Exocet-Polytechnique/ExospineV2/ExoSpineV2/ExoSpineV2_schematic.pdf

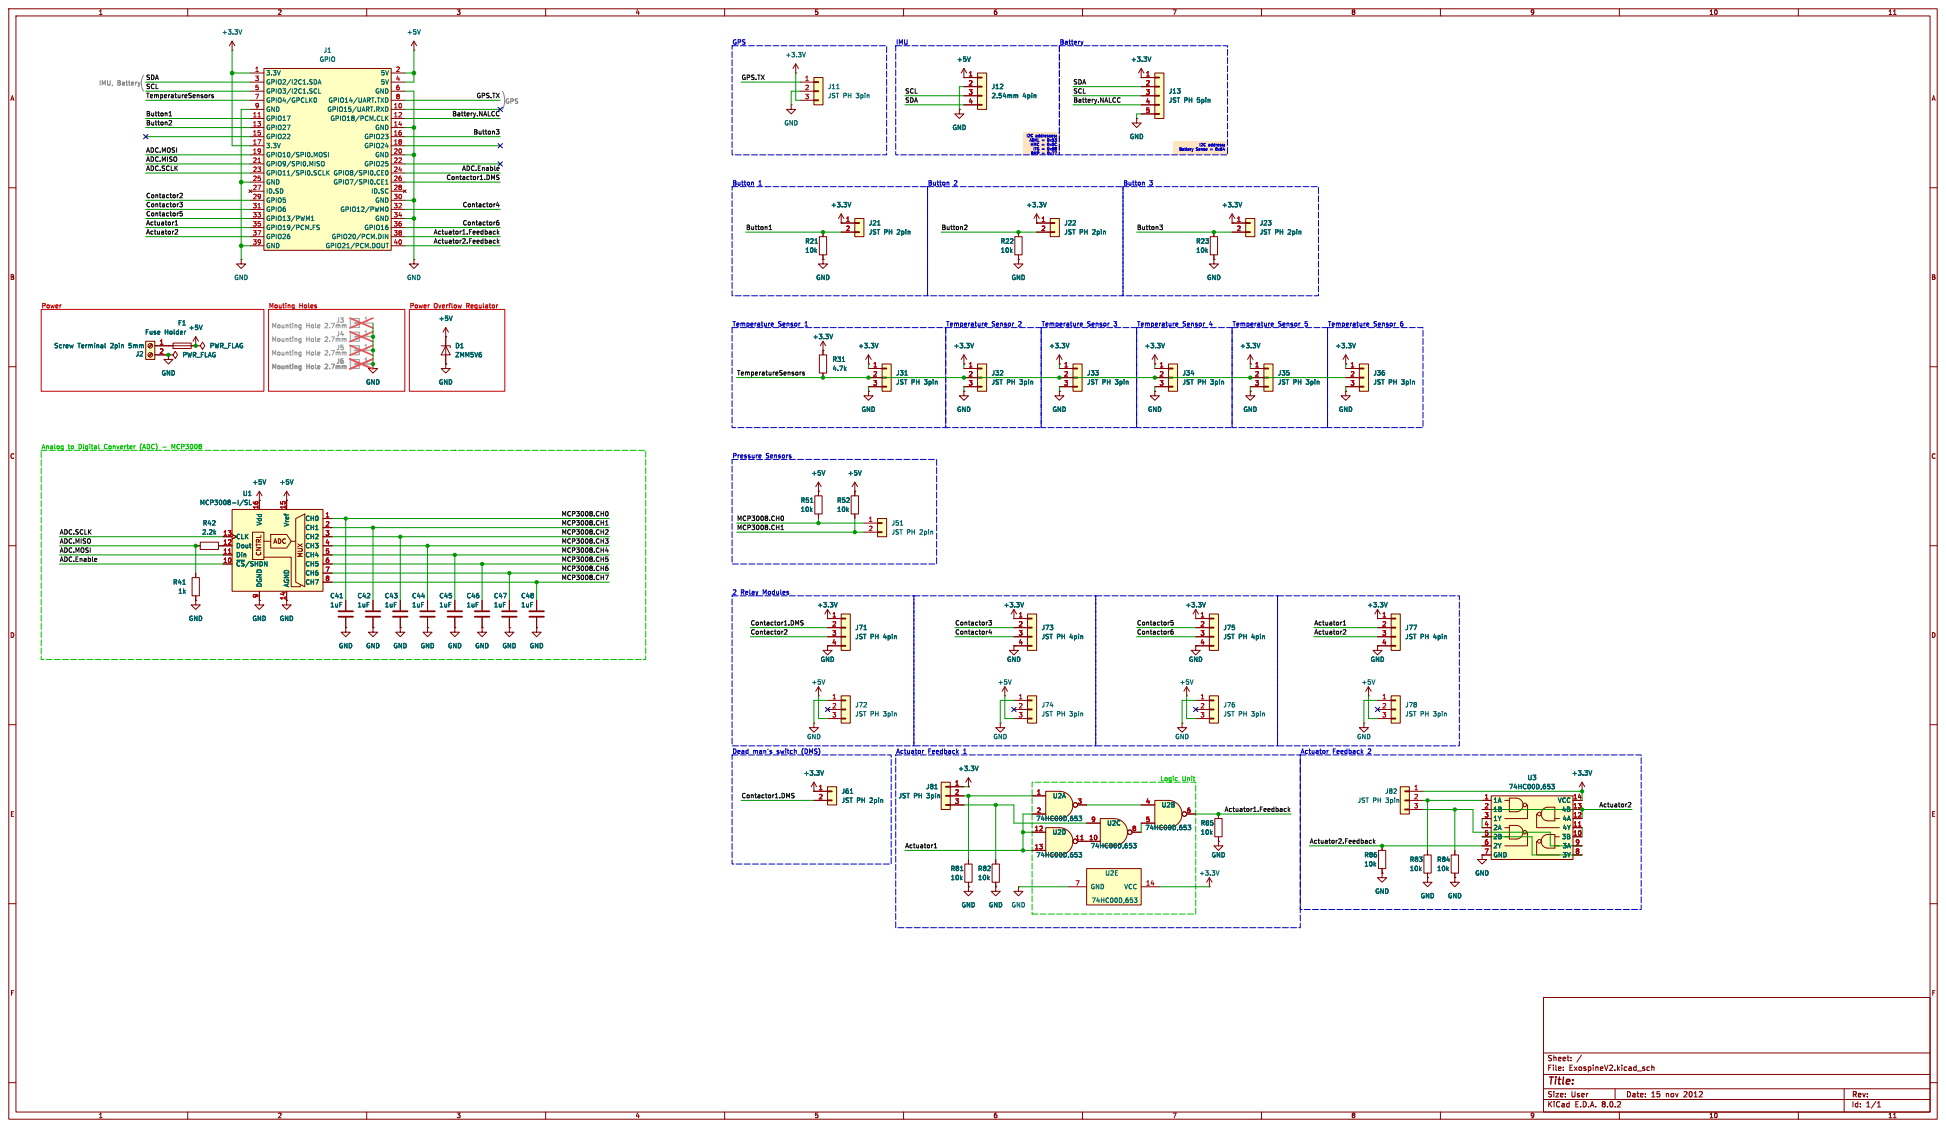
[picture p1: page 1]

Contactor2 Actuator1 Actuator2 Contactor5 ADC.MOSI Button2 Button1 SCL SDA

Id: 1/1 Title: File: ExospineV2.kicad_sch Sheet: /
