Exocet-Polytechnique/ExospineV2/ExoSpineV2/ExospineV2_PCB_back_layer.pdf

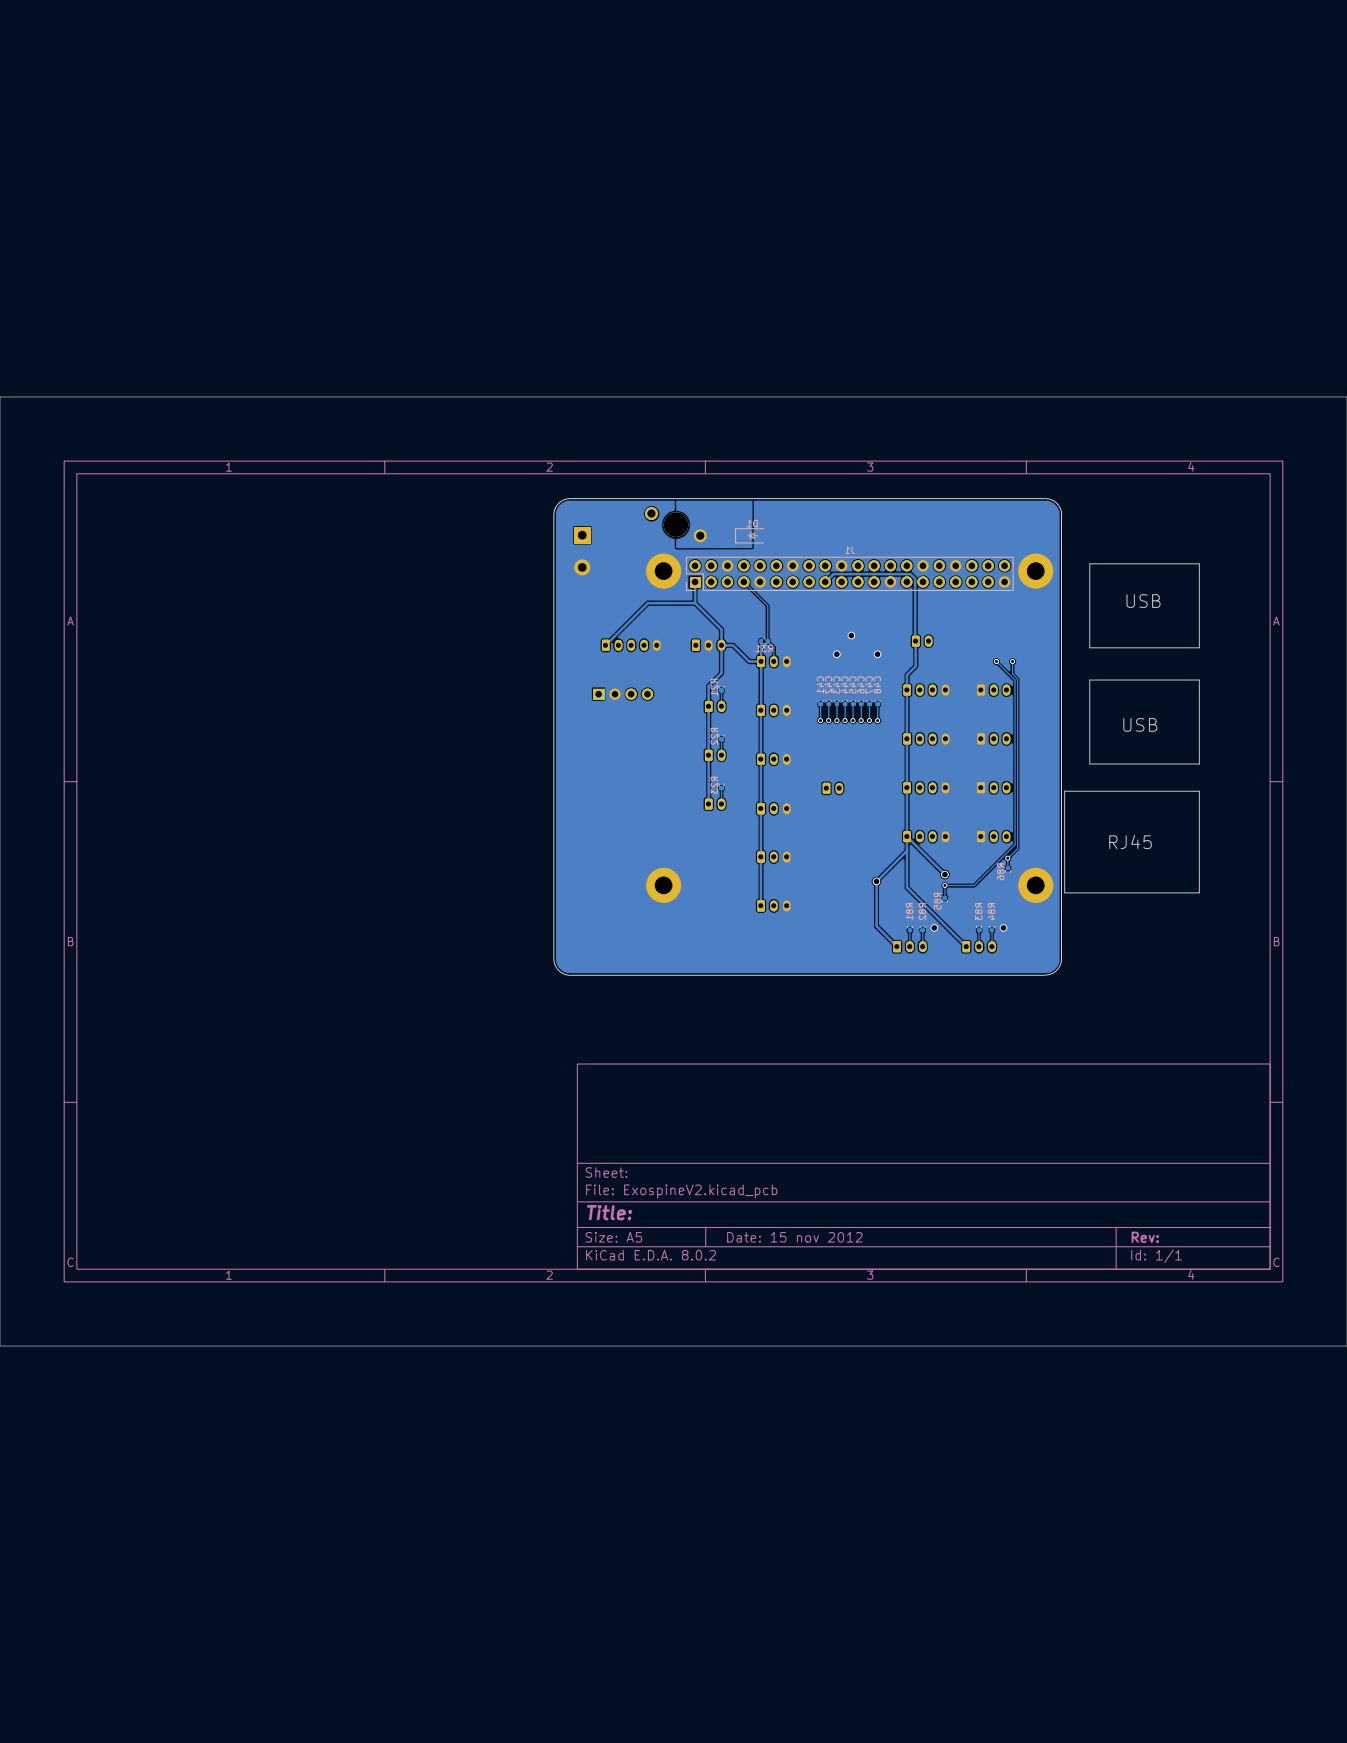
[picture p2: page 1]
