Exocet-Polytechnique/ExospineV2/ExoSpineV2/ExospineV2_PCB_front_layer.pdf

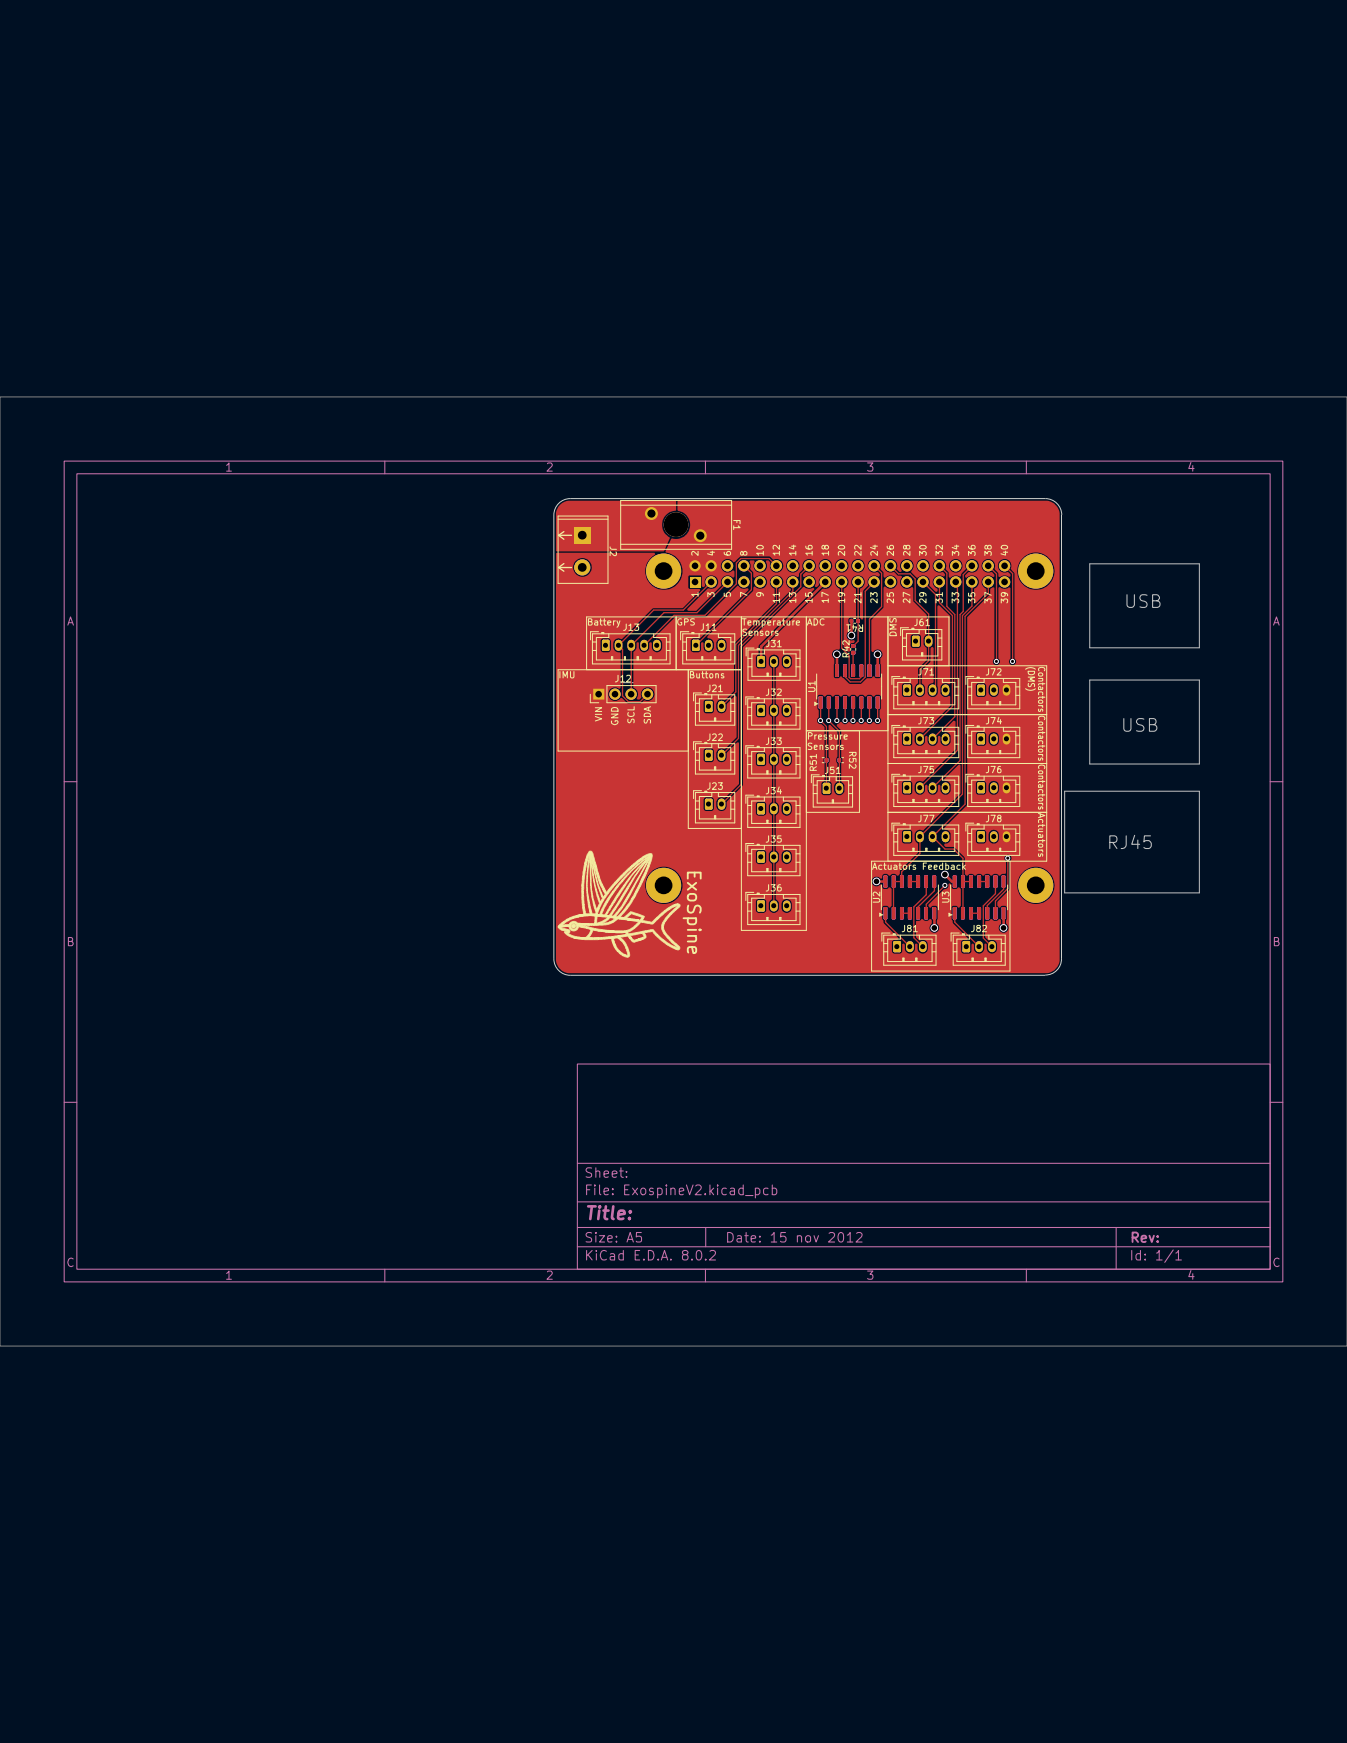
[picture p3: page 1]
