Exocet-Polytechnique/ExospineV2/ExoSpineV2/ExospineV2.kicad_pcb

## KiCad design ExoSpineV2/ExospineV2.kicad_pcb (2024-05-23)

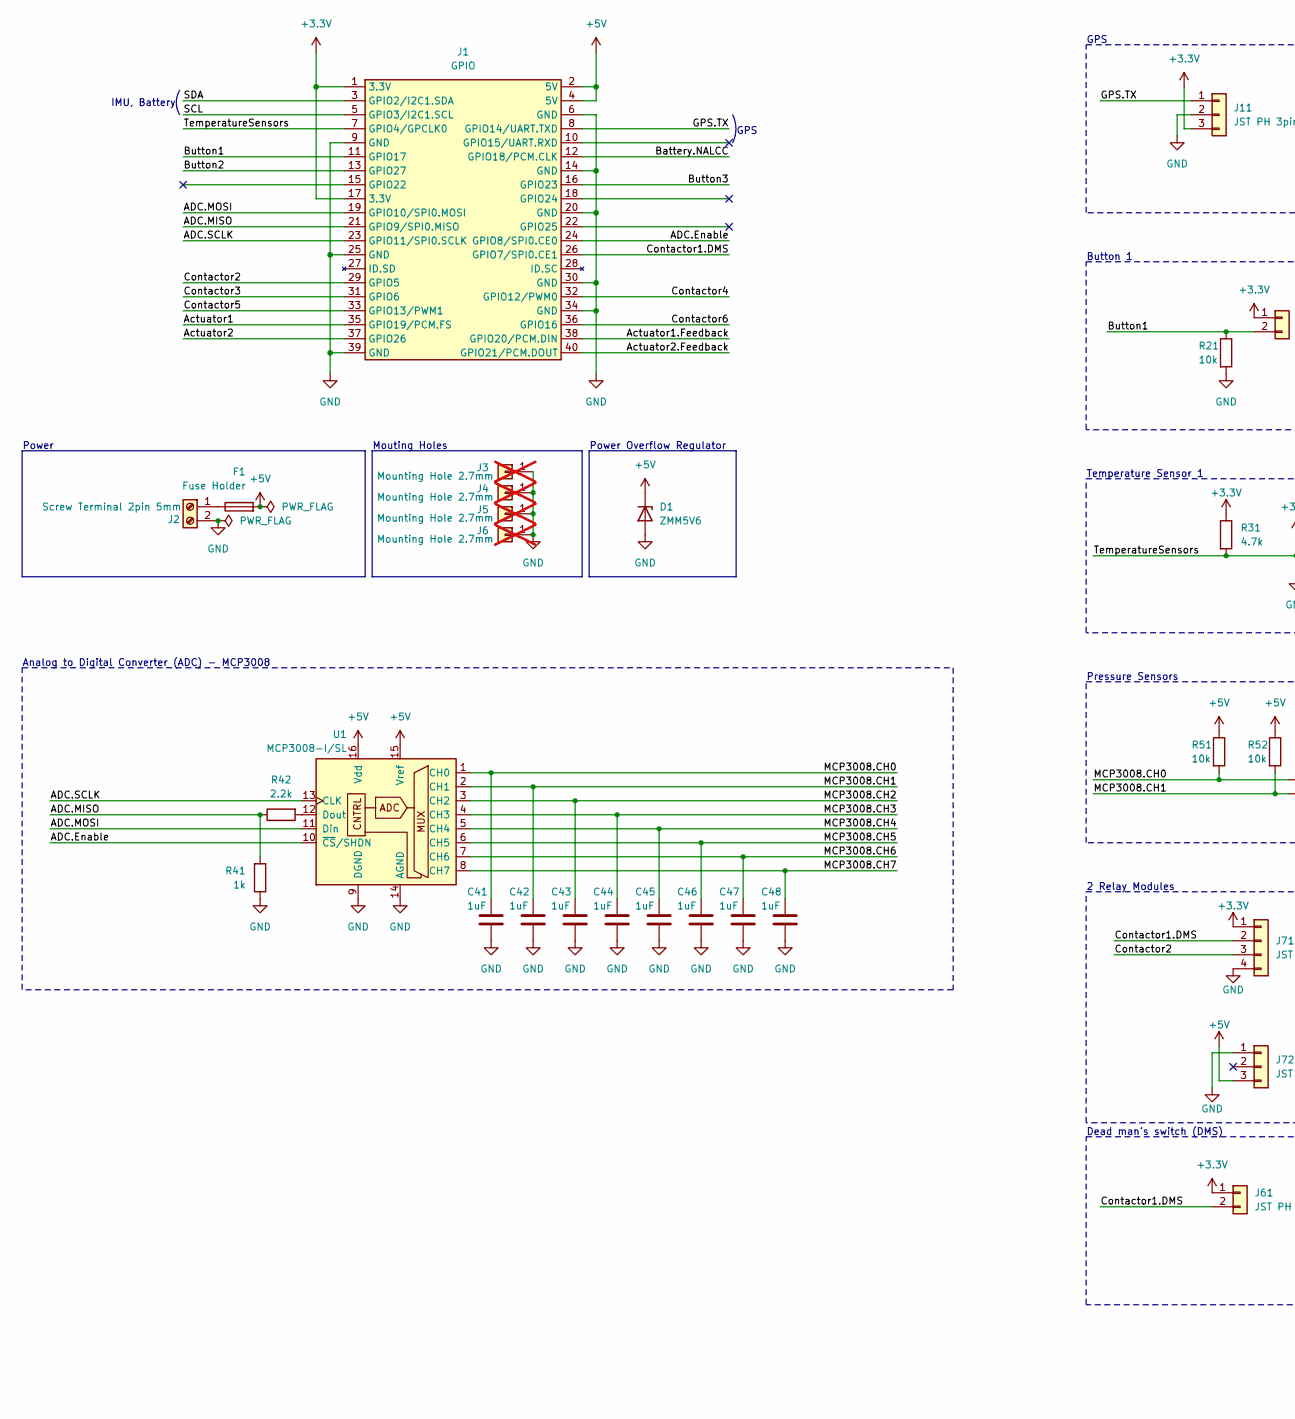
[picture p4: schematic ExospineV2.kicad_sch, part in row 1, column 1]

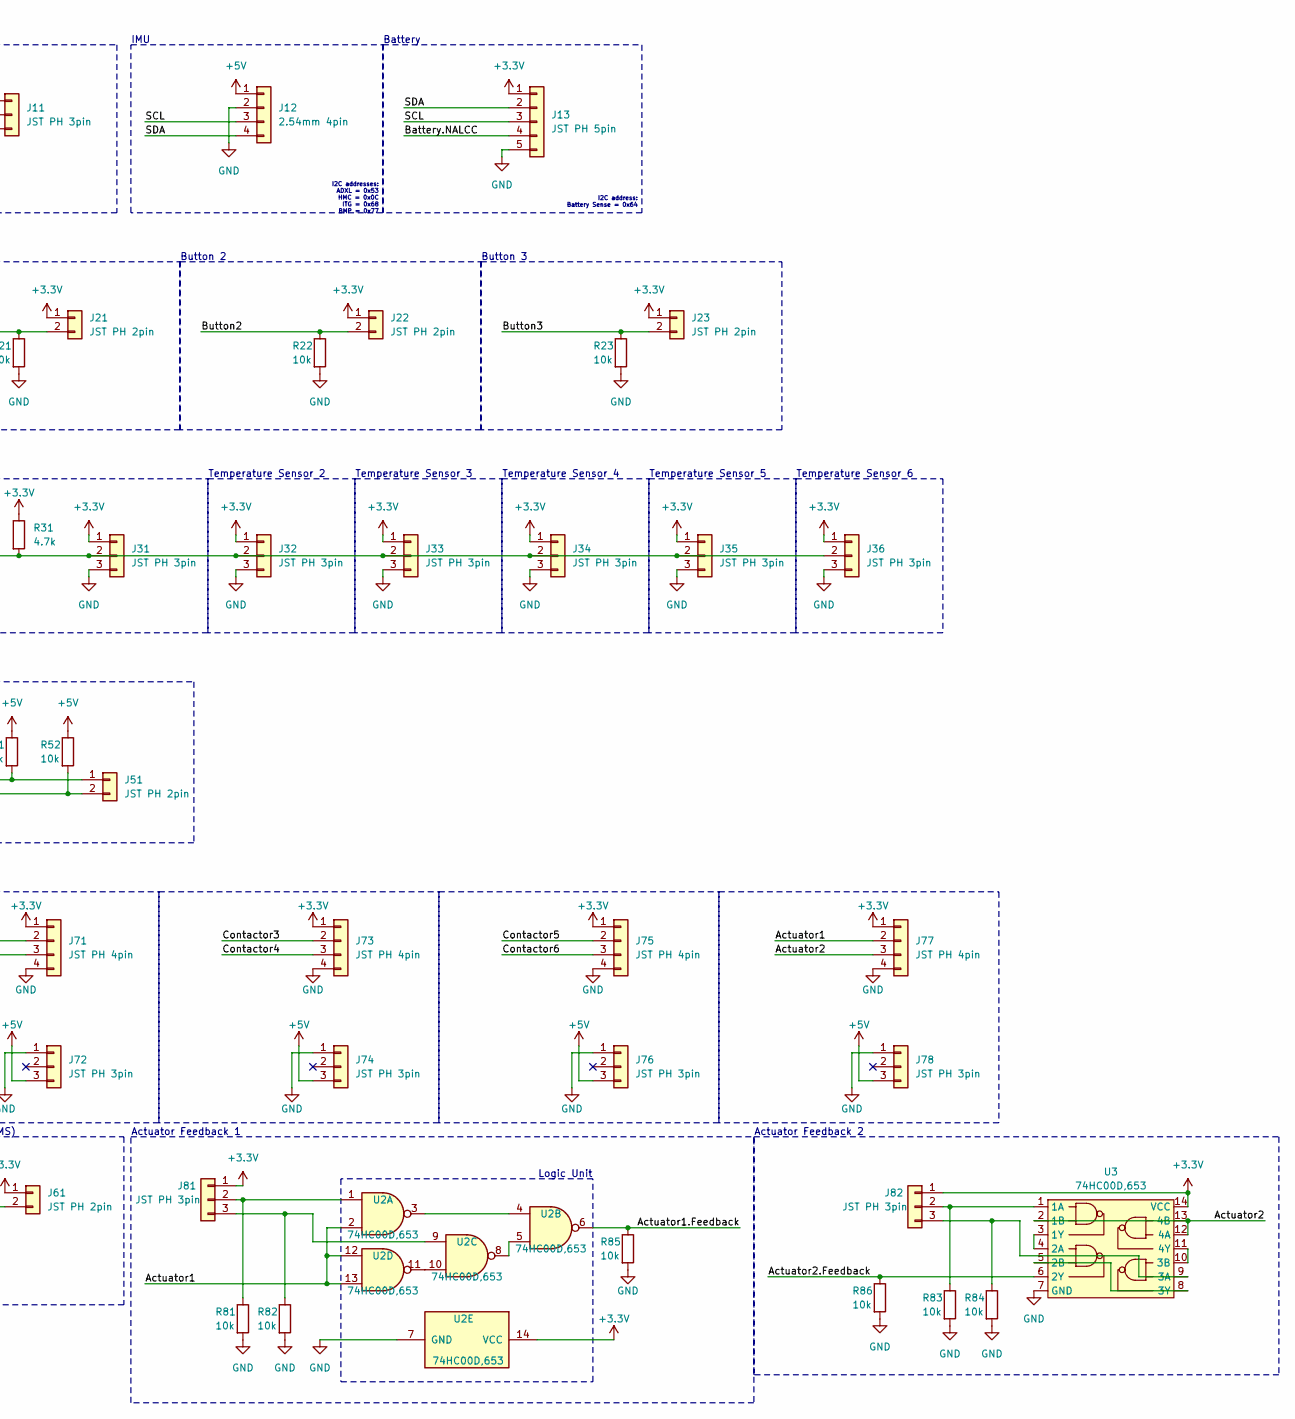
[picture p5: schematic ExospineV2.kicad_sch, part in row 1, column 2]

Parts:
C41, C42, C43, C44, C45, C46, C47, C48: 1uF; C_0402_1005Metric; JLCPCB Part Number C52923
D1: ZMM5V6; D_MiniMELF; JLCPCB Part Number C5345993
F1: Fuse Holder; [Mouser~]01530008(Littelfuse); JLCPCB Part Number C206907
J1: GPIO; PinSocket_2x20_P2.54mm_Vertical; JLCPCB Part Number C2977589
J2: Screw Terminal 2pin 5mm; [Exocet]MX126-5.0-02P-GN01-Cu-S-A; JLCPCB Part Number C5188434
J3, J4, J5, J6: Mounting Hole 2.7mm; MountingHole_2.7mm_Pad; not fitted
J11, J31, J32, J33, J34, J35, J36, J72, J74, J76, J78, J81, J82: JST PH 3pin; JST_PH_B3B-PH-K_1x03_P2.00mm_Vertical; JLCPCB Part Number C131339
J12: 2.54mm 4pin; PinHeader_1x04_P2.54mm_Vertical; JLCPCB Part Number C5116483
J13: JST PH 5pin; JST_PH_B5B-PH-K_1x05_P2.00mm_Vertical; JLCPCB Part Number C157993
J21, J22, J23, J51, J61: JST PH 2pin; JST_PH_B2B-PH-K_1x02_P2.00mm_Vertical; JLCPCB Part Number C131337
J71, J73, J75, J77: JST PH 4pin; JST_PH_B4B-PH-K_1x04_P2.00mm_Vertical; JLCPCB Part Number C131334
R21, R22, R23, R51, R52, R81, R82, R83, R84, R85, R86: 10k; R_0402_1005Metric; JLCPCB Part Number C25744
R31: 4.7k; R_0402_1005Metric; JLCPCB Part Number C25900
R41: 1k; R_0402_1005Metric; JLCPCB Part Number C11702
R42: 2.2k; R_0402_1005Metric; JLCPCB Part Number C25879
U1: MCP3008-I/SL; SOIC-16_3.9x9.9mm_P1.27mm; JLCPCB Part Number C1520159
U2, U3: 74HC00D,653; SOIC-14_3.9x8.7mm_P1.27mm; JLCPCB Part Number C5586

Connections:
+3.3V: J1.1 (3.3V), J1.17 (3.3V), J11.3, J13.1, J21.1, J22.1, J23.1, J31.1, J32.1, J33.1, J34.1, J35.1, J36.1, J61.1, J71.1, J73.1, J75.1, J77.1, J81.1, J82.1, R31.1, U2.14 (VCC), U3.14 (VCC)
+5V: D1.1 (K), F1.2, J1.2 (5V), J1.4 (5V), J12.1, J72.3, J74.3, J76.3, J78.3, R51.1, R52.1, U1.15 (Vref), U1.16 (Vdd)
/ADC.Enable: J1.24 (GPIO8/SPI0.CE0), U1.10 (~CS/SHDN)
/ADC.MISO: J1.21 (GPIO9/SPI0.MISO), R41.2, R42.1
/ADC.MOSI: J1.19 (GPIO10/SPI0.MOSI), U1.11 (Din)
/ADC.SCLK: J1.23 (GPIO11/SPI0.SCLK), U1.13 (CLK)
/Actuator1: J1.35 (GPIO19/PCM.FS), J77.2, U2.2, U2.12, U2.13
/Actuator1.Feedback: J1.38 (GPIO20/PCM.DIN), R85.1, U2.6
/Actuator2: J1.37 (GPIO26), J77.3, U3.2 (1B), U3.12 (4A), U3.13 (4B)
/Actuator2.Feedback: J1.40 (GPIO21/PCM.DOUT), R86.1, U3.6 (2Y)
/Battery.NALCC: J1.12 (GPIO18/PCM.CLK), J13.4
/Button1: J1.11 (GPIO17), J21.2, R21.1
/Button2: J1.13 (GPIO27), J22.2, R22.1
/Button3: J1.16 (GPIO23), J23.2, R23.1
/Contactor1.DMS: J1.26 (GPIO7/SPI0.CE1), J61.2, J71.2
/Contactor2: J1.29 (GPIO5), J71.3
/Contactor3: J1.31 (GPIO6), J73.2
/Contactor4: J1.32 (GPIO12/PWM0), J73.3
/Contactor5: J1.33 (GPIO13/PWM1), J75.2
/Contactor6: J1.36 (GPIO16), J75.3
/GPS.TX: J1.8 (GPIO14/UART.TXD), J11.1
/MCP3008.CH0: C41.1, J51.1, R51.2, U1.1 (CH0)
/MCP3008.CH1: C42.1, J51.2, R52.2, U1.2 (CH1)
/MCP3008.CH2: C43.1, U1.3 (CH2)
/MCP3008.CH3: C44.1, U1.4 (CH3)
/MCP3008.CH4: C45.1, U1.5 (CH4)
/MCP3008.CH5: C46.1, U1.6 (CH5)
/MCP3008.CH6: C47.1, U1.7 (CH6)
/MCP3008.CH7: C48.1, U1.8 (CH7)
/SCL: J1.5 (GPIO3/I2C1.SCL), J12.3, J13.3
/SDA: J1.3 (GPIO2/I2C1.SDA), J12.4, J13.2
/TemperatureSensors: J1.7 (GPIO4/GPCLK0), J31.2, J32.2, J33.2, J34.2, J35.2, J36.2, R31.2
GND: C41.2, C42.2, C43.2, C44.2, C45.2, C46.2, C47.2, C48.2, D1.2 (A), J1.6 (GND), J1.9 (GND), J1.14 (GND), J1.20 (GND), J1.25 (GND), J1.30 (GND), J1.34 (GND), J1.39 (GND), J2.2, J3.1, J4.1, J5.1, J6.1, J11.2, J12.2, J13.5, J31.3, J32.3, J33.3, J34.3, J35.3, J36.3, J71.4, J72.1, J73.4, J74.1, J75.4, J76.1, J77.4, J78.1, R21.2, R22.2, R23.2, R41.1, R81.2, R82.2, R83.2, R84.2, R85.2, R86.2, U1.9 (DGND), U1.14 (AGND), U2.7 (GND), U3.7 (GND)
unnamed: F1.1, J2.1
unnamed: J81.2, R81.1, U2.1
unnamed: J81.3, R82.1, U2.9
unnamed: J82.2, R83.1, U3.1 (1A)
unnamed: J82.3, R84.1, U3.9 (3A)
unnamed: R42.2, U1.12 (Dout)
unnamed: U2.3, U2.4
unnamed: U2.5, U2.8
unnamed: U2.10, U2.11
unnamed: U3.3 (1Y), U3.4 (2A)
unnamed: U3.5 (2B), U3.8 (3Y)
unnamed: U3.10 (3B), U3.11 (4Y)

Notes on the sheet:
I2C address: Battery Sense = 0x64
I2C addresses: ADXL = 0x53 HMC = 0x0C ITG = 0x68 BMP = 0x77
Actuator Feedback 1
IMU, Battery
Button 3
Mouting Holes
Power Overflow Regulator
Temperature Sensor 6
2 Relay Modules
Battery
Temperature Sensor 1
IMU
Power
Button 2
GPS
Temperature Sensor 3
Pressure Sensors
Actuator Feedback 2
Button 1
Logic Unit
Analog to Digital Converter (ADC) - MCP3008
Temperature Sensor 5
Temperature Sensor 2
Temperature Sensor 4
Dead man's switch (DMS)

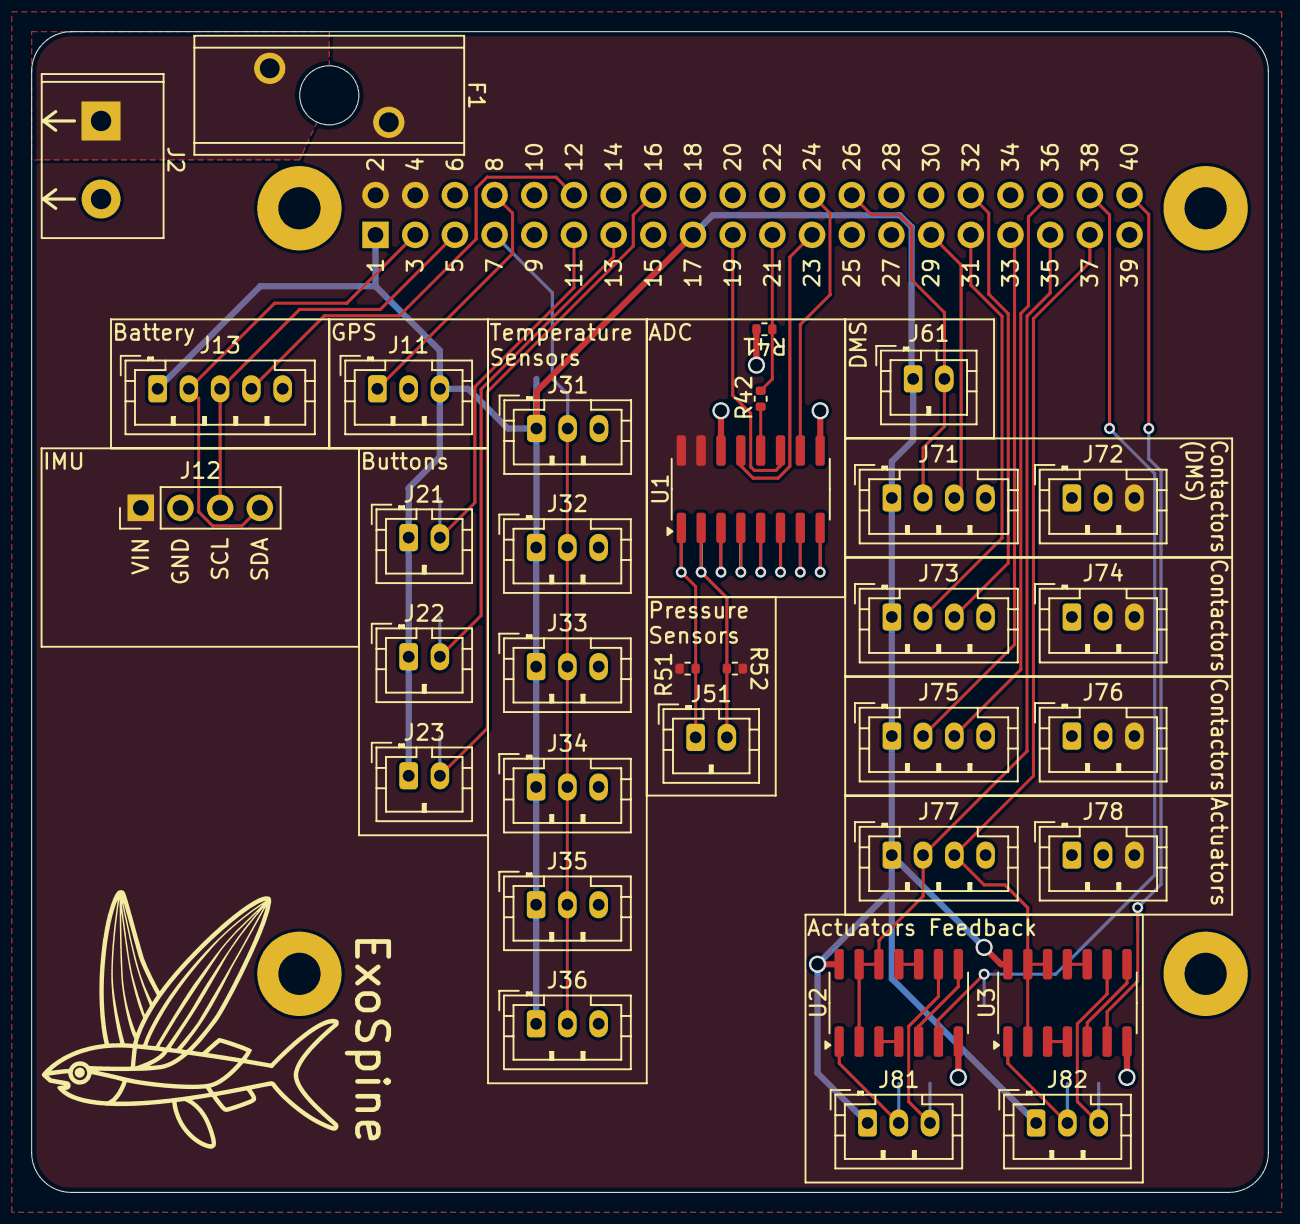
[picture p6: board ExospineV2.kicad_pcb from above]

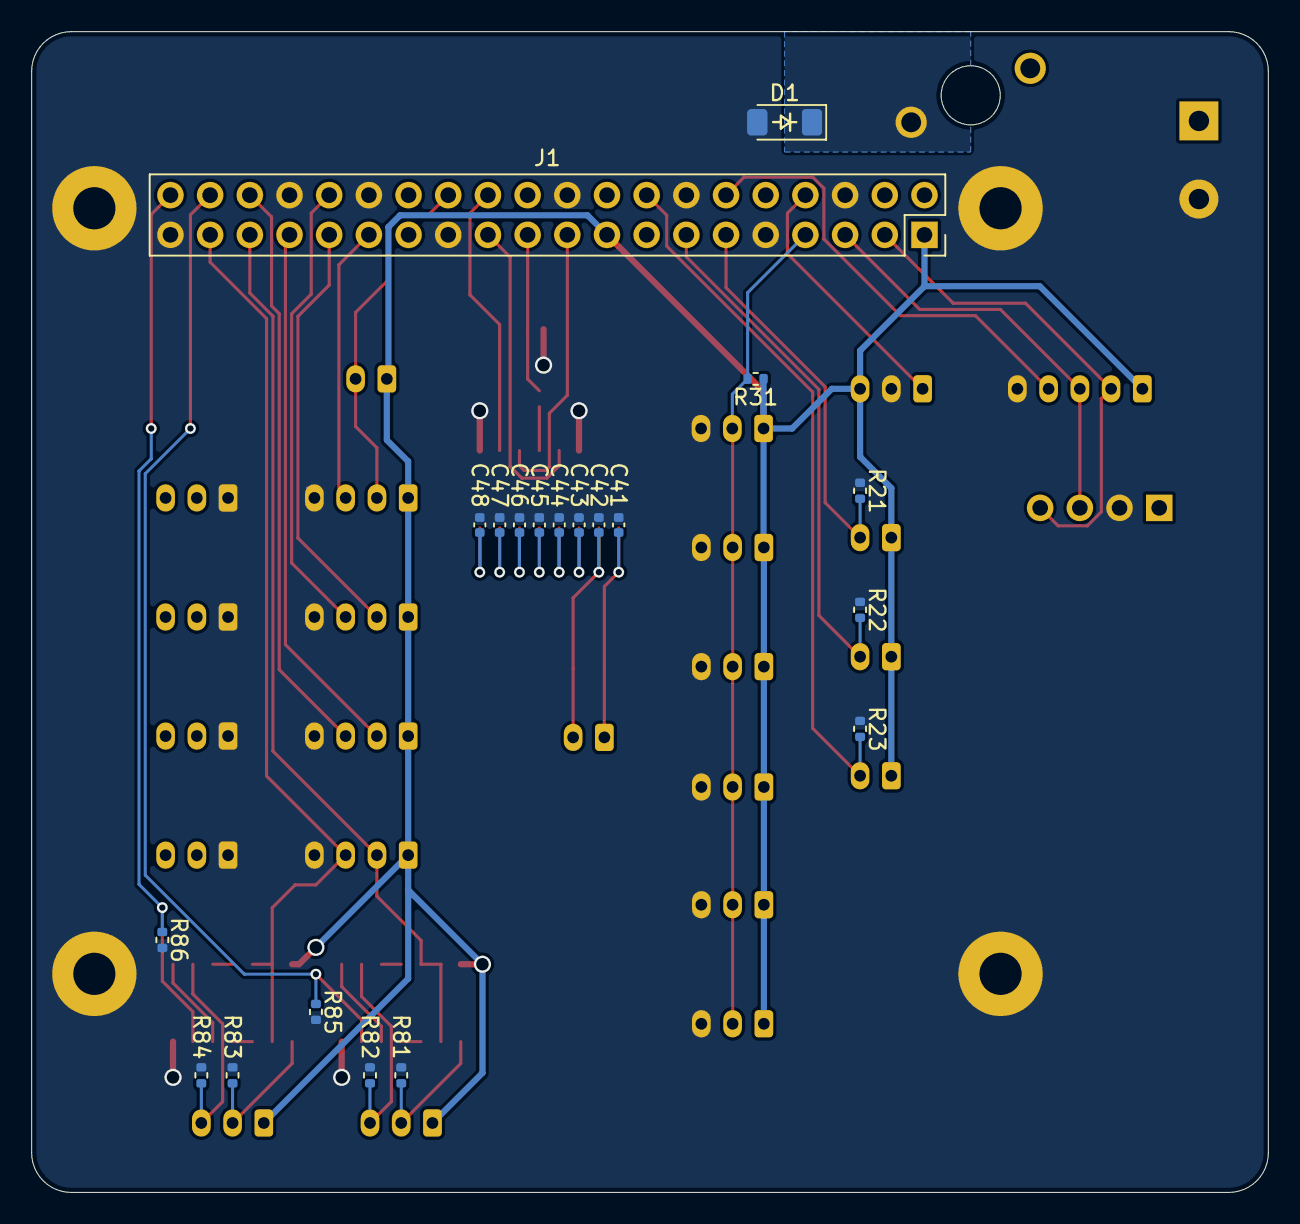
[picture p7: board ExospineV2.kicad_pcb from below]

Board: 2 copper layers, 79.2 x 74.3 mm, 57 parts (20 on the bottom side), 45 nets.
