Exocet-Polytechnique/ExospineV2/(threads)

Thread 10 (2024-01-30):

Ajouter des connecteurs pour le bouton et pour les capteurs de température

xelorax, 2024-01-30:
Il est nécessaire de faire une liste exaustive des besoins du bateau et de ne rien oublier. Des boutons devront être implémentés, certains dans les circuits de puissance, d'autre avec l'ordinateur de bord. Les capteurs doivent chaqu'un avoir le connecteur pertinent sur le board et dans la boite pour faire interface entre l'intérieur et l'extérieur des boites de commande.

Closed 2024-05-14.

Thread 11 (2024-01-30):

Implémenter le circuit des manomètres

xelorax, 2024-01-30:
On a deux manomètres, un AG400 21 AO et un AG4 21AO.
Le manomètre est dans la configuration 3wire
+4  -3
+1 -3

À faire : circuit
À faire: commande socket M 12x 1, 4pin circular connector

Closed 2024-05-14.

Thread 6 (2024-01-30):

Actuateurs (2)

xelorax, 2024-01-30:
Implémenter le circuit des Actuateurs (pour les valves de l'hydrogène). Voir le schéma des actuateurs.
Il faut un circuit avec 24V et un circuit de contrôle utilisant 2 pin par fuelcell.

gumile, 2024-02-07:
2

Closed 2024-05-14.

Thread 7 (2024-01-30):

Dimensionner et choisir les Condensateurs, les inductances et les résistances du circuit

xelorax, 2024-01-30:
Les condensateurs, résistances et bobines sont plein d'éléments essentiels du circuits qui nécessitent d'être chosis, dimentionnés et leur footprint doit être définie.
Il suffit de s'assurer pour chaque composante que la puissance dépasse ce qui est attendu et que les tolérances sont adéquates. C'est difficile de dire ce qui a besoin de tolérances précises, se référer à la specsheet des composantes

Closed 2024-05-14.

Thread 8 (2024-01-30):

Approcher certains connecteurs du bord pour qu'ils soient plus facile d'accès

xelorax, 2024-01-30:
Certaines connections sont trop éloignées du bord pour être des connecteurs horizontals. Choisir des connecteurs verticals ou s'assurer de positionner les connecteurs horisontals à proximité du bord

Closed 2024-05-14.

Thread 13 (2024-02-04):

Module de détection du niveau de la batterie

efondere, 2024-02-04:
De ce que je comprend de [cette page](https://electronics.stackexchange.com/questions/5522/battery-level-how-to-check). Il existe deux méthode pour ça:
1. Mesurer l'intensité du courant à la sortie de la batterie quand elle est utilisée
2. Mesurer le voltage aux bornes de la batterie

La première serait à privilégier pour avoir une mesure plus précise.

[Cet article](https://www.mpoweruk.com/soc.htm) semble aussi intéressant à lire.

Thread 15 (2024-02-08):

Implémenter le circuit des manomètres #11

xelorax, 2024-02-08:
On a deux manomètres, un AG400 21 AO et un AG4 21AO.
Le manomètre est dans la configuration 3wire
+4 -3
+1 -3

À faire : circuit
À faire: commande socket M 12x 1, 4pin circular connector

Closed 2024-05-14.

Thread 17 (2024-02-08):

Approcher certains connecteurs du bord pour qu'ils soient plus facile d'accès

xelorax, 2024-02-08:
Certaines connections sont trop éloignées du bord pour être des connecteurs horizontals. Choisir des connecteurs verticals ou s'assurer de positionner les connecteurs horisontals à proximité du bord

Closed 2024-05-14.

Thread 20 (2024-02-08):

Dimensionner et choisir les Condensateurs, les inductances et les résistances du circuit

xelorax, 2024-02-08:
Les condensateurs, résistances et bobines sont plein d'éléments essentiels du circuits qui nécessitent d'être chosis, dimentionnés et leur footprint doit être définie.
Il suffit de s'assurer pour chaque composante que la puissance dépasse ce qui est attendu et que les tolérances sont adéquates. C'est difficile de dire ce qui a besoin de tolérances précises, se référer à la specsheet des composantes

**Overdimensionner au lieu de underdimensionner**

Closed 2024-05-14.

Thread 21 (2024-02-08):

Schéma du bouton

xelorax, 2024-02-08:
Implémenter un schéma de bouton pour l'allumage et l'éteignage des circuits du bateau.

gumile, 2024-02-14:
Il n'y a qu'un seul bouton pour démarrer/arrêter dans le code python

Closed 2024-05-14.

Thread 23 (2024-05-04):

Résistance pour les manomètres branchée au mauvais endroit

efondere, 2024-05-04:
Pour les deux manomètres, le GND devrait être remplacé par 5V (même voltage que l'ADC):
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

Si on regarde le schéma des manomètres, la résistance R_L est connectée d'un côté au GND et de l'autre côté à S+, donc il faut connecter une résistance entre le signal et 5V pour avoir du courant et donc lire la mesure:
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

Closed 2024-05-14.
