Exocet-Polytechnique/ExospineV2/(commit log)

2024-01-26 Minor changes
    [ExospineV2.kicad_pcb, ExospineV2.kicad_sch]
2024-01-26 Ajout de pin assignment du Raspberry Pi
    [ExospineV2.kicad_sch]
2024-01-28 ajouté des noms au Raspberry
2024-01-28 Remove KiCad-generated files
2024-01-28 Move projet to root directory (rebase from main)
    [ExospineV2.kicad_pcb, ExospineV2.kicad_sch]
2024-01-28 Ajout d'un raspberryPi modèle
    [ExospineV2.kicad_pcb, ExospineV2.kicad_sch]
2024-01-28 Move files
    [ExospineV2.kicad_pcb, ExospineV2.kicad_sch]
2024-01-28 created MCP3008 and imported ExoSpineV1
    [ExoSpineV1.kicad_sch, ExospineV2.kicad_pcb, ExospineV2.kicad_sch, MCP3008.kicad_sch, untitled.kicad_sch]
2024-01-28 created CPU circuits
    [ExospineV2.kicad_sch, MCP3008.kicad_sch]
2024-01-29 ajout début alimentation 5v
    [Alimentation12-5v.kicad_sch, ExospineV2.kicad_sch]
2024-01-29 ajout des capteurs de pression (x3) et d'un peu d'info sur le dcdc12-5v
    [Alimentation12-5v.kicad_sch, ExospineV2.kicad_sch, MCP3008.kicad_sch]
2024-01-30 probablement pas de grandes modifications
    [ExoSpineV1.kicad_sch, ExospineV2.kicad_sch, MCP3008.kicad_sch]
2024-01-30 ajout de condensateur de decouplage pour les thermistances
    [ExospineV2.kicad_sch]
2024-01-30 jsp ce que j'ai fait mais j'ai avancé
    [Alimentation12-5v.kicad_sch, ExospineV2.kicad_sch, MCP3008.kicad_sch]
2024-02-07 Temperature Sensor 1
    [ExospineV2.kicad_sch]
2024-02-09 Added actuators logic circuits
    [ExospineV2.kicad_sch]
2024-02-09 modified actuators
    [ExospineV2.kicad_sch]
2024-02-12 Created `ElectricalLayout`
    [Alimentation12-5v.kicad_sch]
2024-02-13 MCP3008 circuit
    [ExospineV2.kicad_sch]
2024-02-13 moved MCP3008_and_channels schematic to EletricLayout
    [MCP3008_and_channels.kicad_sch]
2024-02-13 Actuator Control 1
    [ExospineV2.kicad_sch]
2024-02-13 Actuator Control 2 and backup
    [ExospineV2.kicad_sch]
2024-02-13 Identified RP pins
    [ExospineV2.kicad_sch]
2024-02-13 Added 12V connector on PCB
    [ExospineV2.kicad_sch]
2024-02-13 Added Pressure Sensors 1 and 2
    [ExospineV2.kicad_sch]
2024-02-13 Added Pressure Sensor Backup
    [ExospineV2.kicad_sch]
2024-02-13 Correction for Actuator Controls (12V down to 5V)
    [ExospineV2.kicad_sch]
2024-02-13 Added Contactors 2 and 3
    [ExospineV2.kicad_sch]
2024-02-13 Added Temperature Sensors
    [ExospineV2.kicad_sch]
2024-02-13 Modified Logic Circuit for Actuators Feedback
    [ExospineV2.kicad_sch]
2024-02-13 12v or 5v?
    [ExospineV2.kicad_sch]
2024-02-13 Added logic circuit for actuators feedback
    [ExospineV2.kicad_sch]
2024-02-14 petits changements
    [ExospineV2.kicad_sch]
2024-02-14 normalement le merge est fait, faut que on travaille chaqu'un de son côté ou que on s'assure de truc genre Merge souvent pcq sinon ça part en couilles
    [ExospineV2.kicad_sch]
2024-02-14 rajout de la fiche du convertisseur dc-dc buck converter qui baisse la tension pour alimenter le Pi
    [12v-5vBuckConverter.kicad_sch, ExospineV2.kicad_sch]
2024-02-14 Added I2C addresses
    [12v-5vBuckConverter.kicad_sch, ExospineV2.kicad_sch]
2024-02-15 Modified temperature sensors connectors
    [ExospineV2.kicad_sch]
2024-02-22 planned mux and LTC2942
    [ExospineV2.kicad_sch]
2024-03-05 added LTC4312 circuit
    [ExospineV2.kicad_sch, LTC4312.kicad_sch]
2024-03-05 Added connections to batteries PCBs
    [ExospineV2.kicad_sch, LTC4312.kicad_sch]
2024-03-05 added connection type for GPS
    [ExospineV2.kicad_sch, LTC4312.kicad_sch]
2024-03-21 added connectors
    [ExospineV2.kicad_sch]
2024-03-21 modified battery feedback control (switch)
    [LTC4312.kicad_sch]
2024-03-28 chose 10k resistors on JLCPCB (datasheets & footprints)
    [ExospineV2.kicad_sch, LTC4312.kicad_sch]
2024-03-29 chose resistors and capacitors
    [ExospineV2.kicad_sch, LTC4312.kicad_sch]
2024-04-01 dimensionnement des composantes pour le DC-DC
    [12v-5vBuckConverter.kicad_sch, ExospineV2.kicad_sch, LTC4312.kicad_sch]
2024-04-04 ajout de composantes au board
    [12v-5vBuckConverter.kicad_sch, ExospineV2.kicad_pcb, ExospineV2.kicad_sch, LTC4312.kicad_sch]
2024-04-05 dimensionnage de certaines composantes
    [12v-5vBuckConverter.kicad_sch, ExospineV2.kicad_sch]
2024-04-05 changement de un peu de librairies de parts, finition du premier PCB
    [12v-5vBuckConverter.kicad_sch, ExospineV2.kicad_pcb, ExospineV2.kicad_sch, LTC4312.kicad_sch]
2024-04-05 Link de toutes les composantes à utiliser
    [ExospineV2.kicad_pcb, ExospineV2.kicad_sch]
2024-05-08 changed symbols
    [ExospineV2.kicad_sch, LTC4312.kicad_sch]
2024-05-08 removed LTC2944 (?) (bottom left of root page)
    [ExospineV2.kicad_sch]
2024-05-08 changed actuator control circuit
    [ExospineV2.kicad_sch]
2024-05-08 moved ExoSpineV1
    [ExoSpineV1.kicad_sch]
2024-05-08 last commit before removing 12V-5V buck converter
    [ExospineV2.kicad_sch]
2024-05-08 removed 12v-5v buck converter
    [12v-5vBuckConverter.kicad_sch, ExospineV2.kicad_sch]
2024-05-08 removed unused pages (ExoSpineV1 & LTC4312)
    [ExoSpineV1.kicad_sch, ExospineV2.kicad_sch, LTC4312.kicad_sch]
2024-05-09 9 mai 2024
    [ExospineV2.kicad_pcb, ExospineV2.kicad_sch]
2024-05-09 updated symbol fields in schematic
    [ExospineV2.kicad_sch]
2024-05-10 started working on PCB
    [ExospineV2.kicad_pcb, ExospineV2.kicad_sch]
2024-05-10 organizing MCP3008 circuit
    [ExospineV2.kicad_pcb, ExospineV2.kicad_sch]
2024-05-11 last commit before removing old circuit for contactor & replacing it
    [ExospineV2.kicad_pcb, ExospineV2.kicad_sch]
2024-05-11 removed old circuit for contactors
    [ExospineV2.kicad_sch]
2024-05-12 last commit before changing temperature sensors circuit
    [ExospineV2.kicad_pcb, ExospineV2.kicad_sch]
2024-05-13 positioned temperature sensors connectors on PCB
    [ExospineV2.kicad_pcb, ExospineV2.kicad_sch]
2024-05-13 last commit before removing circuit for LTC4312 (I2C Multiplexer)
    [ExospineV2.kicad_pcb, ExospineV2.kicad_sch]
2024-05-13 removed circuit for LTC4312 (I2C Multiplexer)
    [ExospineV2.kicad_pcb, ExospineV2.kicad_sch]
2024-05-14 continued PCB
    [ExospineV2.kicad_pcb, ExospineV2.kicad_sch]
2024-05-15 changed actuator feedback circuit
    [ExospineV2.kicad_pcb, ExospineV2.kicad_sch]
2024-05-15 placed some components on PCB
    [ExospineV2.kicad_pcb, ExospineV2.kicad_sch]
2024-05-15 Kicad 8
    [ExospineV2.kicad_pcb, ExospineV2.kicad_sch]
2024-05-16 sized traces (Power/default)
    [ExospineV2.kicad_pcb, ExospineV2.kicad_sch]
2024-05-16 placed components on the left of the PCB and added traces
    [ExospineV2.kicad_pcb, ExospineV2.kicad_sch]
2024-05-16 places 5V power connector & traces
    [ExospineV2.kicad_pcb, ExospineV2.kicad_sch]
2024-05-16 updated pdf
    [ExospineV2.kicad_pcb]
2024-05-17 added a 2 relay module
    [ExospineV2.kicad_pcb, ExospineV2.kicad_sch]
2024-05-17 removed Throttle circuits (pull-up & pull-down)
    [ExospineV2.kicad_pcb, ExospineV2.kicad_sch]
2024-05-19 updated footprints
    [ExospineV2.kicad_pcb, ExospineV2.kicad_sch]
2024-05-20 added power plane
    [ExospineV2.kicad_pcb, ExospineV2.kicad_sch]
2024-05-20 updated battery connector (ALCC)
    [ExospineV2.kicad_pcb, ExospineV2.kicad_sch]
2024-05-21 clarified net names among other things
    [ExospineV2.kicad_pcb, ExospineV2.kicad_sch]
2024-05-21 added footprints (Power)
    [ExospineV2.kicad_pcb, ExospineV2.kicad_sch]
2024-05-21 fixed some DRC errors
    [ExospineV2.kicad_pcb]
2024-05-21 little modifications
    [ExospineV2.kicad_pcb, ExospineV2.kicad_sch]
2024-05-21 chose all JLCPCB parts
    [ExospineV2.kicad_pcb, ExospineV2.kicad_sch]
2024-05-21 added resistors
    [ExospineV2.kicad_pcb, ExospineV2.kicad_sch]
2024-05-22 added resistors for actuators feedback
    [ExospineV2.kicad_pcb, ExospineV2.kicad_sch]
2024-05-22 fixed errors
    [ExospineV2.kicad_pcb, ExospineV2.kicad_sch]
2024-05-22 added graphics
    [ExospineV2.kicad_pcb]
2024-05-22 fixed problem with the screw terminal
    [ExospineV2.kicad_pcb, ExospineV2.kicad_sch]
2024-05-22 settings for fabrication outputs
    [ExospineV2.kicad_pcb]
2024-05-22 fixed pcb for gerber files
    [ExospineV2.kicad_pcb]
2024-05-23 generating files for order
    [ExospineV2.kicad_pcb, ExospineV2.kicad_sch]
2024-05-23 commit used for the JLCPCB order
    [ExospineV2.kicad_pcb]
